alegoldstein/CycloSense/3D_Models/links.txt

Hall Sensor + Microphone Mount Onshape Link
https://cad.onshape.com/documents/f903b4df1f2a442af8149892/w/e799356482c73f7667d6dd93/e/312f02a086fbc2992ca5250b

Display Mount Case Onshape Link
https://cad.onshape.com/documents/caf3511e3d20a3969fccb9b4/w/38b0af2c9808467499a4df27/e/3e66cc5adb2d64b4f7038e40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
