alegoldstein/CycloSense/3D_Models/EE327_SensorMountFinal.stl

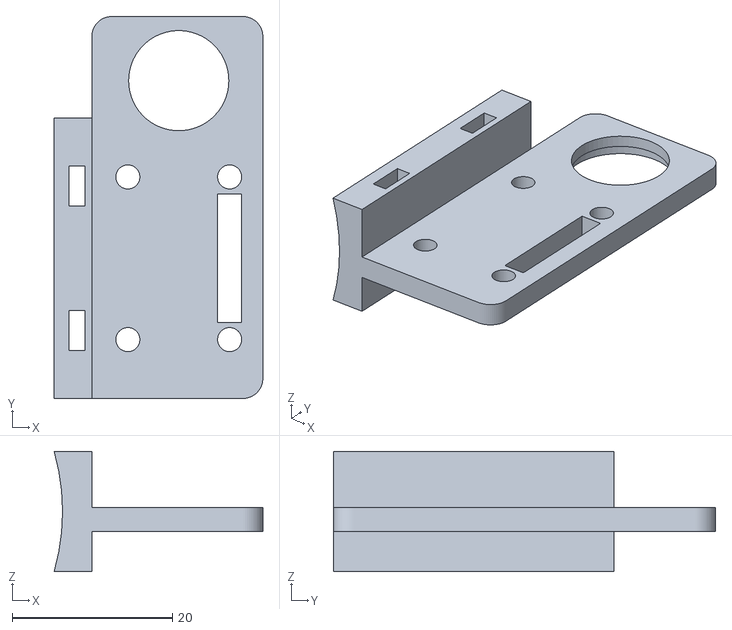
[picture p5: CAD file, 2026-06-12]
3D_Models/EE327_SensorMountFinal.stl
26.1 x 47.7 x 15.0
