alegoldstein/CycloSense/PCB/EE327 KiCAD Files/EE327 - Battery Management/Symbols/MYRBP500080W21RD/MYRBP500080W21RD.step

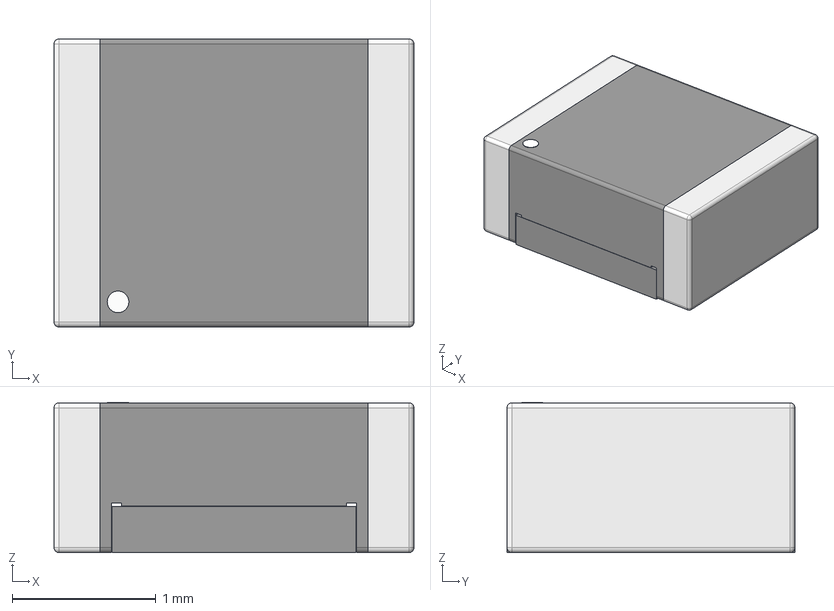
[picture p6: CAD file, 2026-06-10]
PCB/EE327 KiCAD Files/EE327 - Battery Management/Symbols/MYRBP500080W21RD/MYRBP500080W21RD.step
2.50 x 2.00 x 1.04 mm
substrate terminal
substrate
inductor terminal
inductor body
marking
