alegoldstein/CycloSense/PCB/EE327 KiCAD Files/EE327 - Battery Management/Symbols/XCL210C181GR-G/XCL210C181GR-G.step

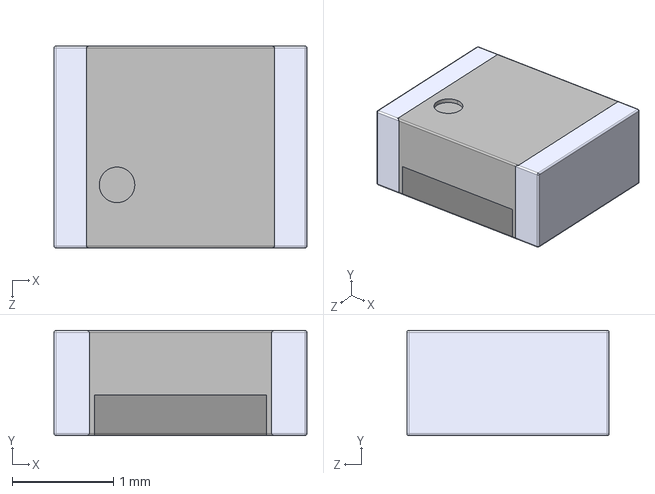
[picture p7: CAD file, 2026-04-30]
PCB/EE327 KiCAD Files/EE327 - Battery Management/Symbols/XCL210C181GR-G/XCL210C181GR-G.step
2.50 x 1.04 x 2.00 mm
