alegoldstein/CycloSense/3D_Models/EE327_DisplayMountFinal.stl

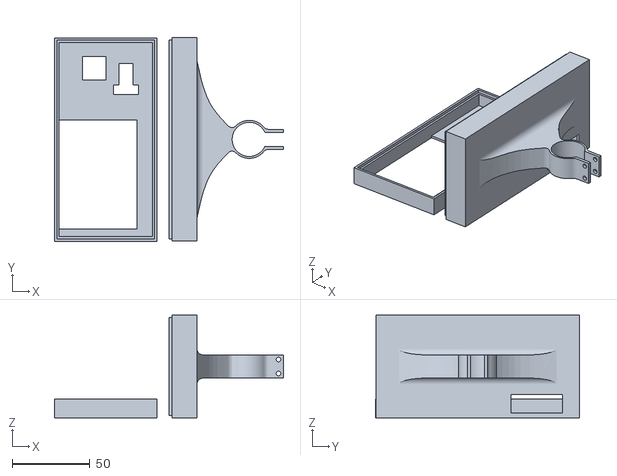
[picture p8: CAD file, 2026-06-12]
3D_Models/EE327_DisplayMountFinal.stl
147.4 x 131.2 x 66.0
