alegoldstein/CycloSense/PCB/EE327 KiCAD Files/EE327 - UI + GPS/EE327 - UI + GPS.kicad_pcb

## KiCad design PCB/EE327 KiCAD Files/EE327 - UI + GPS/EE327 - UI + GPS.kicad_pcb (2026-06-10)

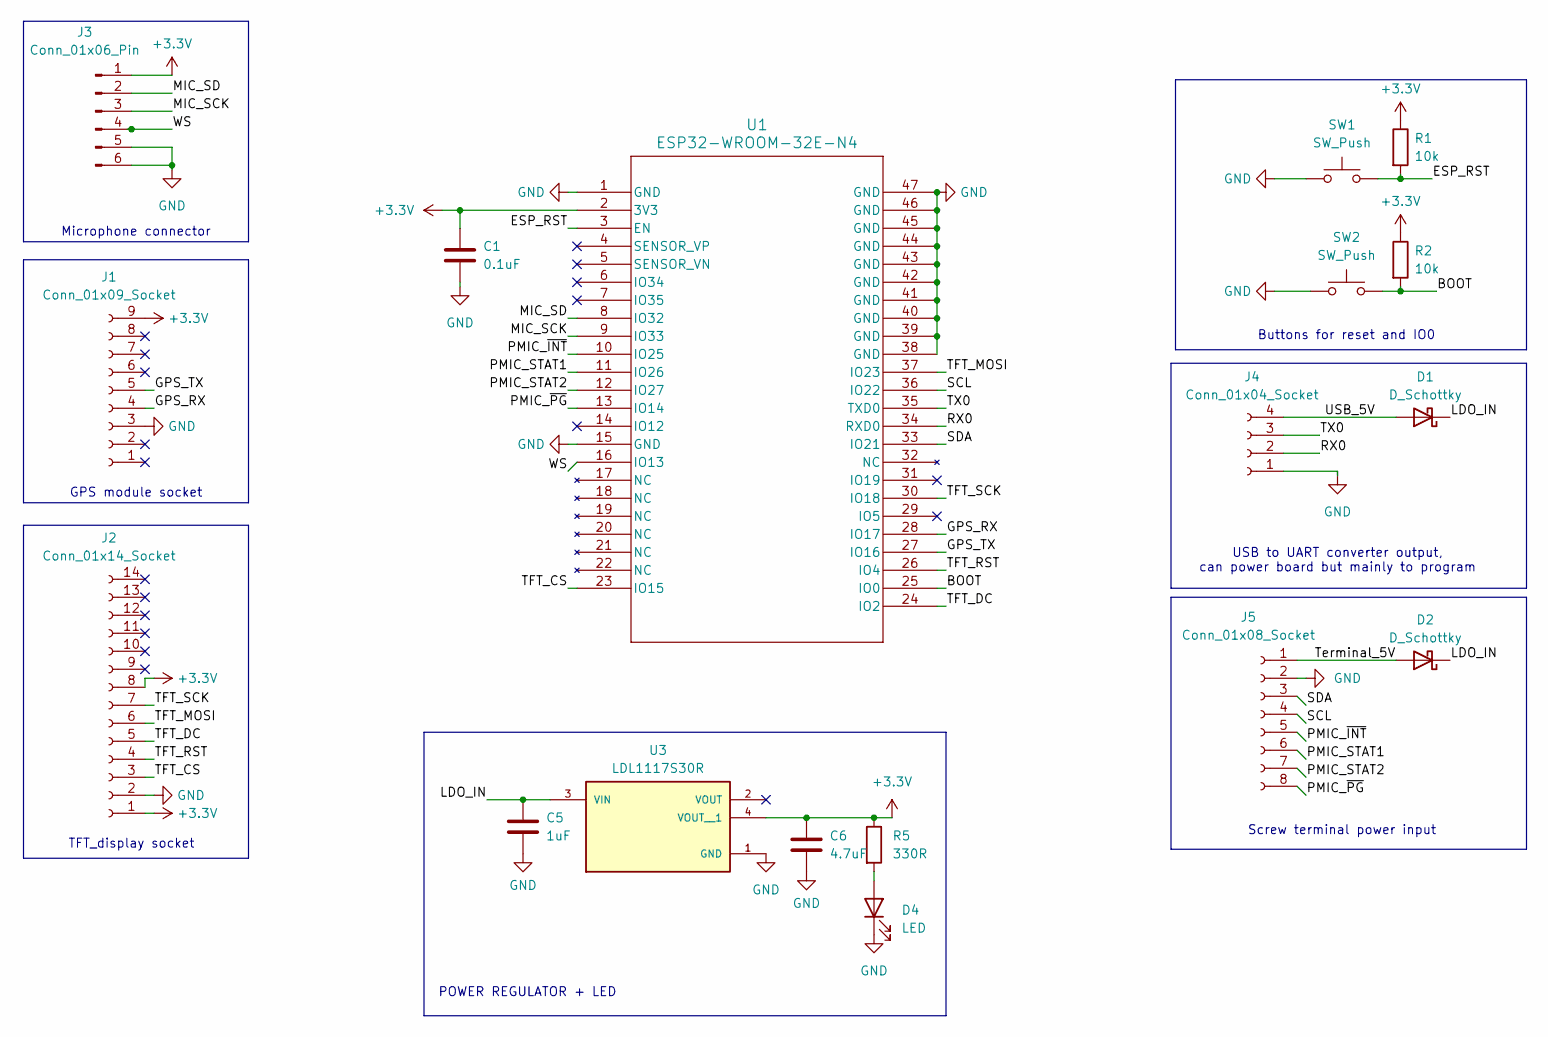
[picture p9: schematic EE327 - UI + GPS.kicad_sch]

Parts:
C1: 0.1uF; C_0805_2012Metric_Pad1.18x1.45mm_HandSolder
C5: 1uF; C_0805_2012Metric_Pad1.18x1.45mm_HandSolder
C6: 4.7uF; C_0805_2012Metric_Pad1.18x1.45mm_HandSolder
D1, D2: D_Schottky; Schottky
D4: LED; LED_0603_1608Metric_Pad1.05x0.95mm_HandSolder
J1: Conn_01x09_Socket; PinHeader_1x09_P2.54mm_Vertical
J2: Conn_01x14_Socket; PinHeader_1x14_P2.54mm_Vertical
J3: Conn_01x06_Pin; 1x6 JST
J4: Conn_01x04_Socket; PinHeader_1x04_P2.54mm_Vertical
J5: Conn_01x08_Socket; CONN_B08B-PNDZS-1_JST
R1, R2: 10k; R_0805_2012Metric_Pad1.20x1.40mm_HandSolder
R5: 330R; R_0805_2012Metric_Pad1.20x1.40mm_HandSolder
SW1, SW2: SW_Push; pushbutton
U1: ESP32-WROOM-32E-N4; ESP32­WROOM­32E_EXP
U3: LDL1117S30R; Voltage Regulator; PARTREV 7

Connections:
+3.3V: C1.1, C6.1, J1.9, J2.1, J2.8, J3.1, R1.1, R2.1, R5.1, U1.2 (3V3), U3.4 (VOUT__1)
/BOOT: R2.2, SW2.2, U1.25 (IO0)
/ESP_RST: R1.2, SW1.2, U1.3 (EN)
/GPS_RX: J1.4, U1.28 (IO17)
/GPS_TX: J1.5, U1.27 (IO16)
/LDO_IN: C5.1, D1.1 (K), D2.1 (K), U3.3 (VIN)
/MIC_SCK: J3.3, U1.9 (IO33)
/MIC_SD: J3.2, U1.8 (IO32)
/PMIC_STAT1: J5.6, U1.11 (IO26)
/PMIC_STAT2: J5.7, U1.12 (IO27)
/PMIC_~INT: J5.5, U1.10 (IO25)
/PMIC_~PG: J5.8, U1.13 (IO14)
/RX0: J4.2, U1.34 (RXD0)
/SCL: J5.4, U1.36 (IO22)
/SDA: J5.3, U1.33 (IO21)
/TFT_CS: J2.3, U1.23 (IO15)
/TFT_DC: J2.5, U1.24 (IO2)
/TFT_MOSI: J2.6, U1.37 (IO23)
/TFT_RST: J2.4, U1.26 (IO4)
/TFT_SCK: J2.7, U1.30 (IO18)
/TX0: J4.3, U1.35 (TXD0)
/Terminal_5V: D2.2 (A), J5.1
/USB_5V: D1.2 (A), J4.4
/WS: J3.4, U1.16 (IO13)
GND: C1.2, C5.2, C6.2, D4.1 (K), J1.3, J2.2, J3.5, J3.6, J4.1, J5.2, SW1.1, SW2.1, U1.1 (GND), U1.15 (GND), U1.38 (GND), U1.39 (GND), U1.40 (GND), U1.41 (GND), U1.42 (GND), U1.43 (GND), U1.44 (GND), U1.45 (GND), U1.46 (GND), U1.47 (GND), U3.1 (GND)
unnamed: D4.2 (A), R5.2

Notes on the sheet:
GPS module socket
Microphone connector
Buttons for reset and IO0
Screw terminal power input
TFT_display socket
USB to UART converter output, can power board but mainly to program
POWER REGULATOR + LED

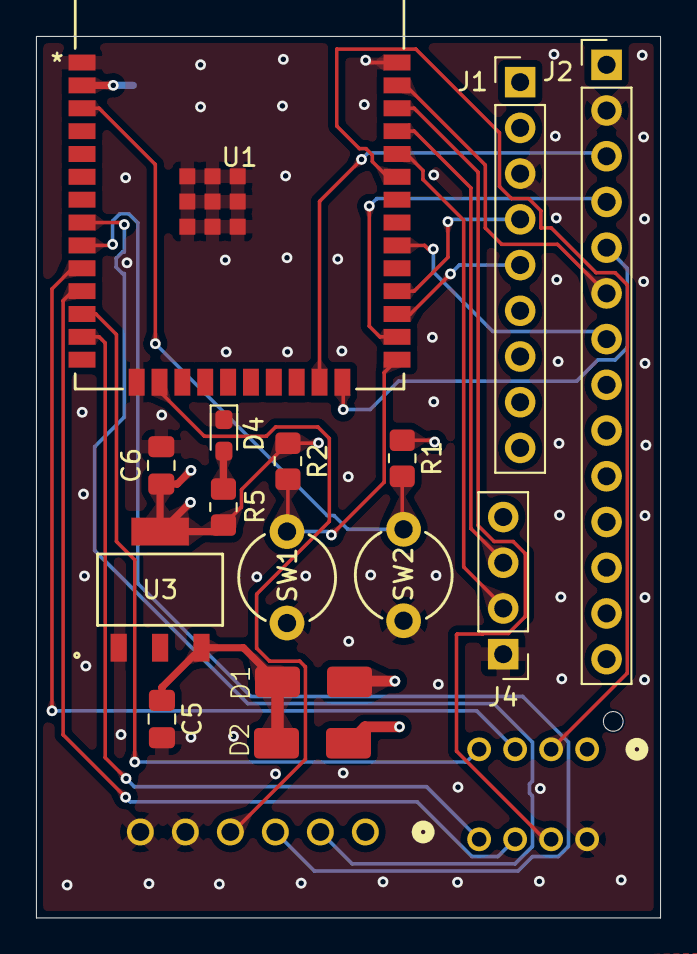
[picture p10: board EE327 - UI + GPS.kicad_pcb from above]

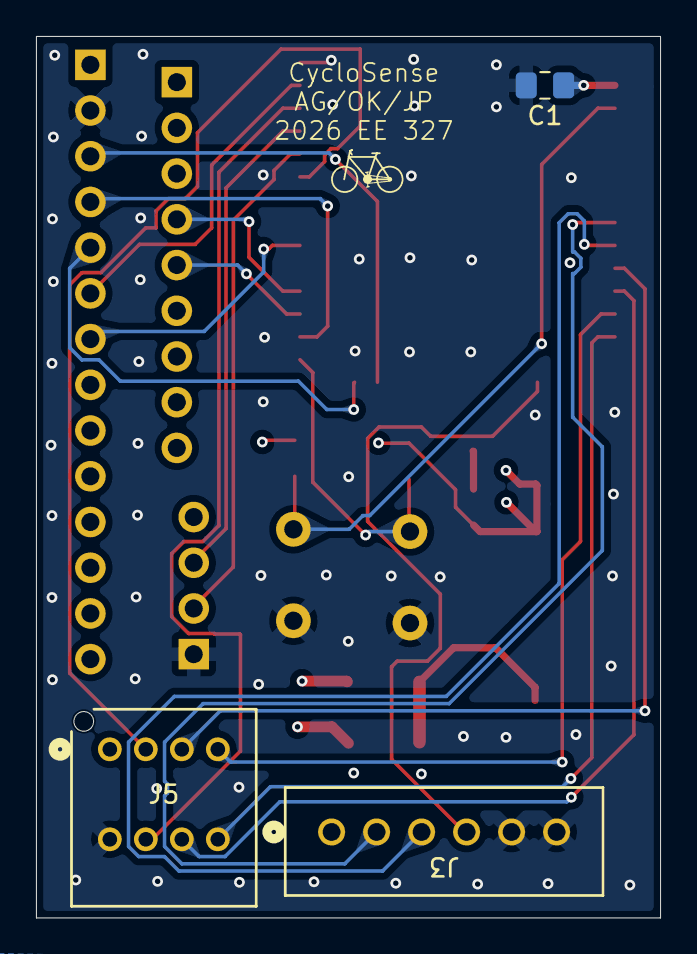
[picture p11: board EE327 - UI + GPS.kicad_pcb from below]

Board: 4 copper layers, 34.7 x 49.0 mm, 18 parts (3 on the bottom side), 26 nets.
