alegoldstein/CycloSense/PCB/EE327 KiCAD Files/EE327 - PMIC Breakout/EE327 - PMIC Breakout.kicad_pcb

## KiCad design PCB/EE327 KiCAD Files/EE327 - PMIC Breakout/EE327 - PMIC Breakout.kicad_pcb (2026-04-30)

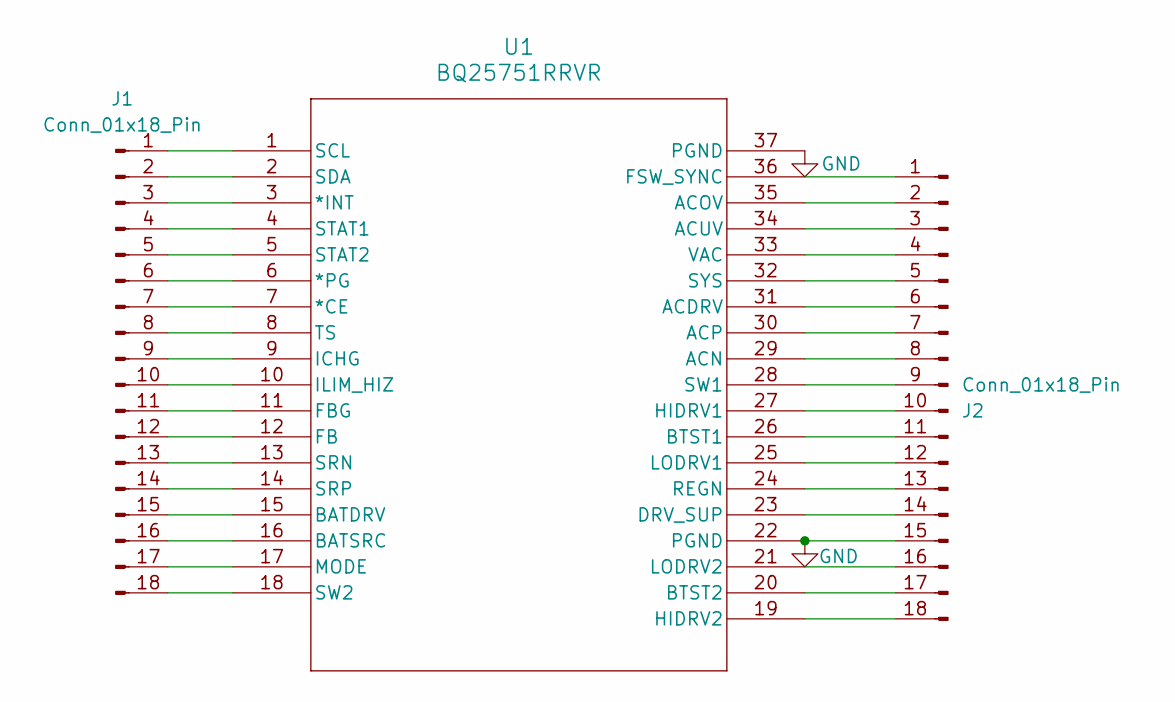
[picture p12: schematic EE327 - PMIC Breakout.kicad_sch]

Parts:
J1, J2: Conn_01x18_Pin; PinHeader_1x18_P2.54mm_Vertical
U1: BQ25751RRVR; VQFN36_RRV_TEX

Connections:
GND: J2.15, U1.22 (PGND), U1.37 (PGND)
unnamed: J1.1, U1.1 (SCL)
unnamed: J1.2, U1.2 (SDA)
unnamed: J1.3, U1.3 (*INT)
unnamed: J1.4, U1.4 (STAT1)
unnamed: J1.5, U1.5 (STAT2)
unnamed: J1.6, U1.6 (*PG)
unnamed: J1.7, U1.7 (*CE)
unnamed: J1.8, U1.8 (TS)
unnamed: J1.9, U1.9 (ICHG)
unnamed: J1.10, U1.10 (ILIM_HIZ)
unnamed: J1.11, U1.11 (FBG)
unnamed: J1.12, U1.12 (FB)
unnamed: J1.13, U1.13 (SRN)
unnamed: J1.14, U1.14 (SRP)
unnamed: J1.15, U1.15 (BATDRV)
unnamed: J1.16, U1.16 (BATSRC)
unnamed: J1.17, U1.17 (MODE)
unnamed: J1.18, U1.18 (SW2)
unnamed: J2.1, U1.36 (FSW_SYNC)
unnamed: J2.2, U1.35 (ACOV)
unnamed: J2.3, U1.34 (ACUV)
unnamed: J2.4, U1.33 (VAC)
unnamed: J2.5, U1.32 (SYS)
unnamed: J2.6, U1.31 (ACDRV)
unnamed: J2.7, U1.30 (ACP)
unnamed: J2.8, U1.29 (ACN)
unnamed: J2.9, U1.28 (SW1)
unnamed: J2.10, U1.27 (HIDRV1)
unnamed: J2.11, U1.26 (BTST1)
unnamed: J2.12, U1.25 (LODRV1)
unnamed: J2.13, U1.24 (REGN)
unnamed: J2.14, U1.23 (DRV_SUP)
unnamed: J2.16, U1.21 (LODRV2)
unnamed: J2.17, U1.20 (BTST2)
unnamed: J2.18, U1.19 (HIDRV2)

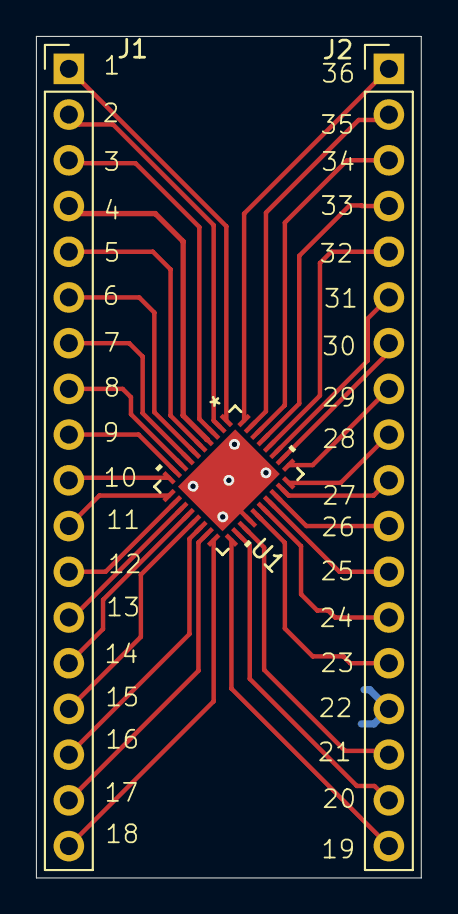
[picture p13: board EE327 - PMIC Breakout.kicad_pcb from above]

Board: 2 copper layers, 21.4 x 46.8 mm, 3 parts (0 on the bottom side), 36 nets.
