alegoldstein/CycloSense/Firmware/NavigationC/src/graph_test.h

/*
 * graph_test.h — synthetic test graph embedded in flash
 *
 * Grid layout (node IDs, 4x4):
 *
 *   0 ---  1 ---  2 ---  3
 *   |      |      |      |
 *   4 ---  5 ---  6 ---  7
 *   |      |      |      |
 *   8 ---  9 --- 10 --- 11
 *   |      |      |      |
 *  12 --- 13 --- 14 --- 15
 *
 * Nodes: 1000 m spacing.  Costs in decimetres (dm).
 * Grid edges: 10 000 dm each (= 1 km).
 *
 * Three extra shortcuts that make the test non-trivial:
 *   0  -> 15 direct :  4 243 dm  ← OPTIMAL  (A* must find this)
 *   0  ->  5        :  3 000 dm  }
 *   5  -> 15        :  3 000 dm  } combined = 6 000 dm, plausible decoy
 *
 * Expected result for astar_find(g, 0, 15, ...):
 *   path  = [0, 15]
 *   len   = 2
 *   cost  = 4 243 dm
 *
 * The naive all-grid path (0->1->2->3->7->11->15) costs 60 000 dm.
 * The decoy two-hop path (0->5->15) costs 6 000 dm.
 * Only A* with proper g-score bookkeeping picks the direct edge.
 */

#ifndef GRAPH_TEST_H
#define GRAPH_TEST_H

#include <stdint.h>

/* 16 nodes, 27 edges, 460 bytes — comfortably fits in IRAM or DRAM */
#define TEST_GRAPH_NODE_COUNT   16u
#define TEST_GRAPH_EDGE_COUNT   27u
#define TEST_GRAPH_BYTE_SIZE    460u

#define TEST_GRAPH_START_NODE   0u
#define TEST_GRAPH_END_NODE     15u

/* Expected outputs — used to validate the result in main.c */
#define TEST_EXPECTED_PATH_LEN  2          /* nodes 0 and 15 */
#define TEST_EXPECTED_COST_DM   4243u      /* dm */

static const uint8_t TEST_GRAPH_BIN[TEST_GRAPH_BYTE_SIZE] = {
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
    0x93, 0x10, 0x02, 0x00, 0x00, 0x00, 0x00, 0x00, 0x05, 0x00, 0x00, 0x00, 0xb8, 0x0b, 0x02, 0x00,
    0x05, 0x00, 0x00, 0x00, 0x0f, 0x00, 0x00, 0x00, 0xb8, 0x0b, 0x02, 0x00,
};

#endif /* GRAPH_TEST_H */
