alegoldstein/CycloSense/(commit log)

2026-04-21 Update README to include PCB design information
2026-04-21 Add files via upload
    create kicad projects for each subsystem
    [EE327 - Battery Management.kicad_pcb, EE327 - Battery Management.kicad_sch, EE327 - UI + GPS.kicad_pcb, EE327 - UI + GPS.kicad_sch, Ee327 - Predictive Maintenence.kicad_pcb, Ee327 - Predictive Maintenence.kicad_sch]
2026-04-30 Added Symbols and Footprints to Battery Management PCB
    [XCL210C181GR-G.step]
2026-04-30 Created PMIC PCB Breakout With Manufacturing Files
    [EE327 - PMIC Breakout-B_Cu.gbr, EE327 - PMIC Breakout-B_Mask.gbr, EE327 - PMIC Breakout-B_Paste.gbr, EE327 - PMIC Breakout-B_Silkscreen.gbr, EE327 - PMIC Breakout-Edge_Cuts.gbr, EE327 - PMIC Breakout-F_Cu.gbr, EE327 - PMIC Breakout-F_Mask.gbr, EE327 - PMIC Breakout-F_Paste.gbr]
2026-05-14 pcb start
    [EE327 - UI + GPS.kicad_sch]
2026-05-21 Audio classification and magnetometer code
2026-05-21 Updated user PCB
    [EE327 - UI + GPS.kicad_sch]
2026-05-21 Created Power Management Schematic Draft
    [EE327 - Battery Management.kicad_sch]
2026-05-22 Added 2x4 JST footprint
    [EE327 - UI + GPS.kicad_pcb]
2026-05-22 PCB routing started
    [EE327 - UI + GPS.kicad_pcb, EE327 - UI + GPS.kicad_sch]
2026-05-23 pcb done?
    [EE327 - UI + GPS.kicad_pcb, EE327 - UI + GPS.kicad_sch]
2026-05-23 Updated mic connections
    [EE327 - UI + GPS.kicad_pcb]
2026-05-24 Resolved lingering DRC errors and generated fabrication files
    [EE327 - UI + GPS-B_Cu.gbl, EE327 - UI + GPS-B_Mask.gbs, EE327 - UI + GPS-B_Paste.gbp, EE327 - UI + GPS-B_Silkscreen.gbo, EE327 - UI + GPS-Edge_Cuts.gm1, EE327 - UI + GPS-F_Cu.gtl, EE327 - UI + GPS-F_Mask.gts, EE327 - UI + GPS-F_Paste.gtp]
2026-05-24 Final PCB directory structure
2026-05-24 Updated PCB directory structure
2026-05-24 Deleted predictive maintenance PCB directory (redundant)
    [Ee327 - Predictive Maintenence.kicad_pcb, Ee327 - Predictive Maintenence.kicad_sch]
2026-05-31 Changed header file directories and began work on magnetometer driver
2026-05-31 TMAG5273 driver and final data acquisition code
2026-06-02 Magnetometer driver and speed calculation
2026-06-03 display speed and map
    [partitions.csv]
2026-06-03 working map display and speed calculation in arduino
2026-06-06 this worked on pcb
2026-06-08 Backend software
    [partitions.csv, pyvenv.cfg]
2026-06-10 Update to PMIC Schematic
    [MYRBP500080W21RD.step]
2026-06-12 stl files
    [EE327_DisplayMountFinal.stl, EE327_SensorMountFinal.stl]
2026-06-12 Final PMIC Schematic
    [EE327 - Battery Management.kicad_sch]
2026-09-14 Update PCB schematic image and remove rendering
    Updated PCB schematic image source and removed PCB rendering section.
